ray33ee/DCT/schematics/debug_board/specs.md

# Debug board

## Features

- Lots of Gnd pins, as pairs scattered around the board for eazy access
- Breakout of entire dev board pins
- Lots of colored LEDs
	- Power LED
	- Hard Fault LED
	- Awaiting uart LED
	- Plus extras that can be connected via wires
- Label every pin
	- STM label
	- Dev board label
	- DCT label
- Reset button via RST (CN7_14)?
- Extra button

71.12
81.28
