ray33ee/DCT/controller/commands.md

# Commands

- Shut down: Turn voltage to 0. Set all pins to NC. Stop execution.
- Set current cutoff: Set the current threshold
- Ramp voltage: Ramp up voltage to desired level, noting the current drawn to detect shorts
- Load test: Take test source code, compile to byte code and send to device
- Start: Start and run a test until completion
- Step: Step over instructions one at a time
- Continue: If stepping, this will run the remainder of the code until completion
- Peek: Get the op and call stack pointers, instruction pointer, next instruction and top of op stack
