ray33ee/DCT/vault/Bytecode file format.md

- Bytecode is stored in a file
- This file contains a header with relevant information such as
	- Test voltage
	- Current limit
	- Pin count
	- Pin layout
	- Seed source (random or provided)
