ray33ee/DCT/vault/VM.md

User code is executed via a 64-bit 64 register VM. Instructions are:

Architecture:

VM uses 64 registers each with 64 bits (labelled r0-r64). Six (r0-r5) are used by the VM for special uses. 20 (r6-r25) are used to pass arguments to functions and to return values from functions. The remaining values (r26-r63) are used as local variables, and these are all you get as this VM does not support stack local variables. 

State:

Machine state is defined as 64 64-bit registers and a stack

- Math (0-19)
	- ADD (0)
	- SUB (1)
	- MUL (2)
	- RNG (3)
- Bitwise Logic (20-39)
	- OR (20)
	- XOR
	- AND
	- INV - One's complement
	- NEG - Two's Complement
	- SHL - Shift left
	- SHR - Shift right
	- BOOL
	- NOT 
- Control flow (40-59)
	- JMP (40)
	- ALLOC (41)
	- CALL (42)
	- RET (43)
	- EQ (44)
	- NE (45)
	- GT (46)
	- LT (47)
	- GE (48)
	- LE (49)
	- JT (50)
	- JF (51)
- Data transfer (60-79)
	- PUSHI
	- POPC
	- PUSHL
	- POPL
	- DROP
- GPIO setup (80-99)
	- SETUP - Setup pin 
	- READ - Read pin
	- WRITE - Write pin
- Timing (100-119)
	- DLA - Milliseconds delay
	- DLB - Microseconds delay
- USI (SPI, UART, I2C, 1-WIRE) (120-139)
- Misc (200-250)
	- HALT
	- SPEEK - Serial send peek
	- SPOP - Serial send pop

Bytecode:

Opcodes are 6 bit (upper 2 bits reserved for extended jumps), register indices are 1 byte, immediates are 4 byte, pin indices are 1 byte, pin setup codes are 1 byte, jump addresses are 34-bit (32 bit plus 2 bits borrowed from opcodes, allowing jumps in files spanning 16GB)
