ray33ee/DCT/schematics/micro/micro.kicad_pcb

## KiCad design schematics/micro/micro.kicad_pcb (2025-07-21)

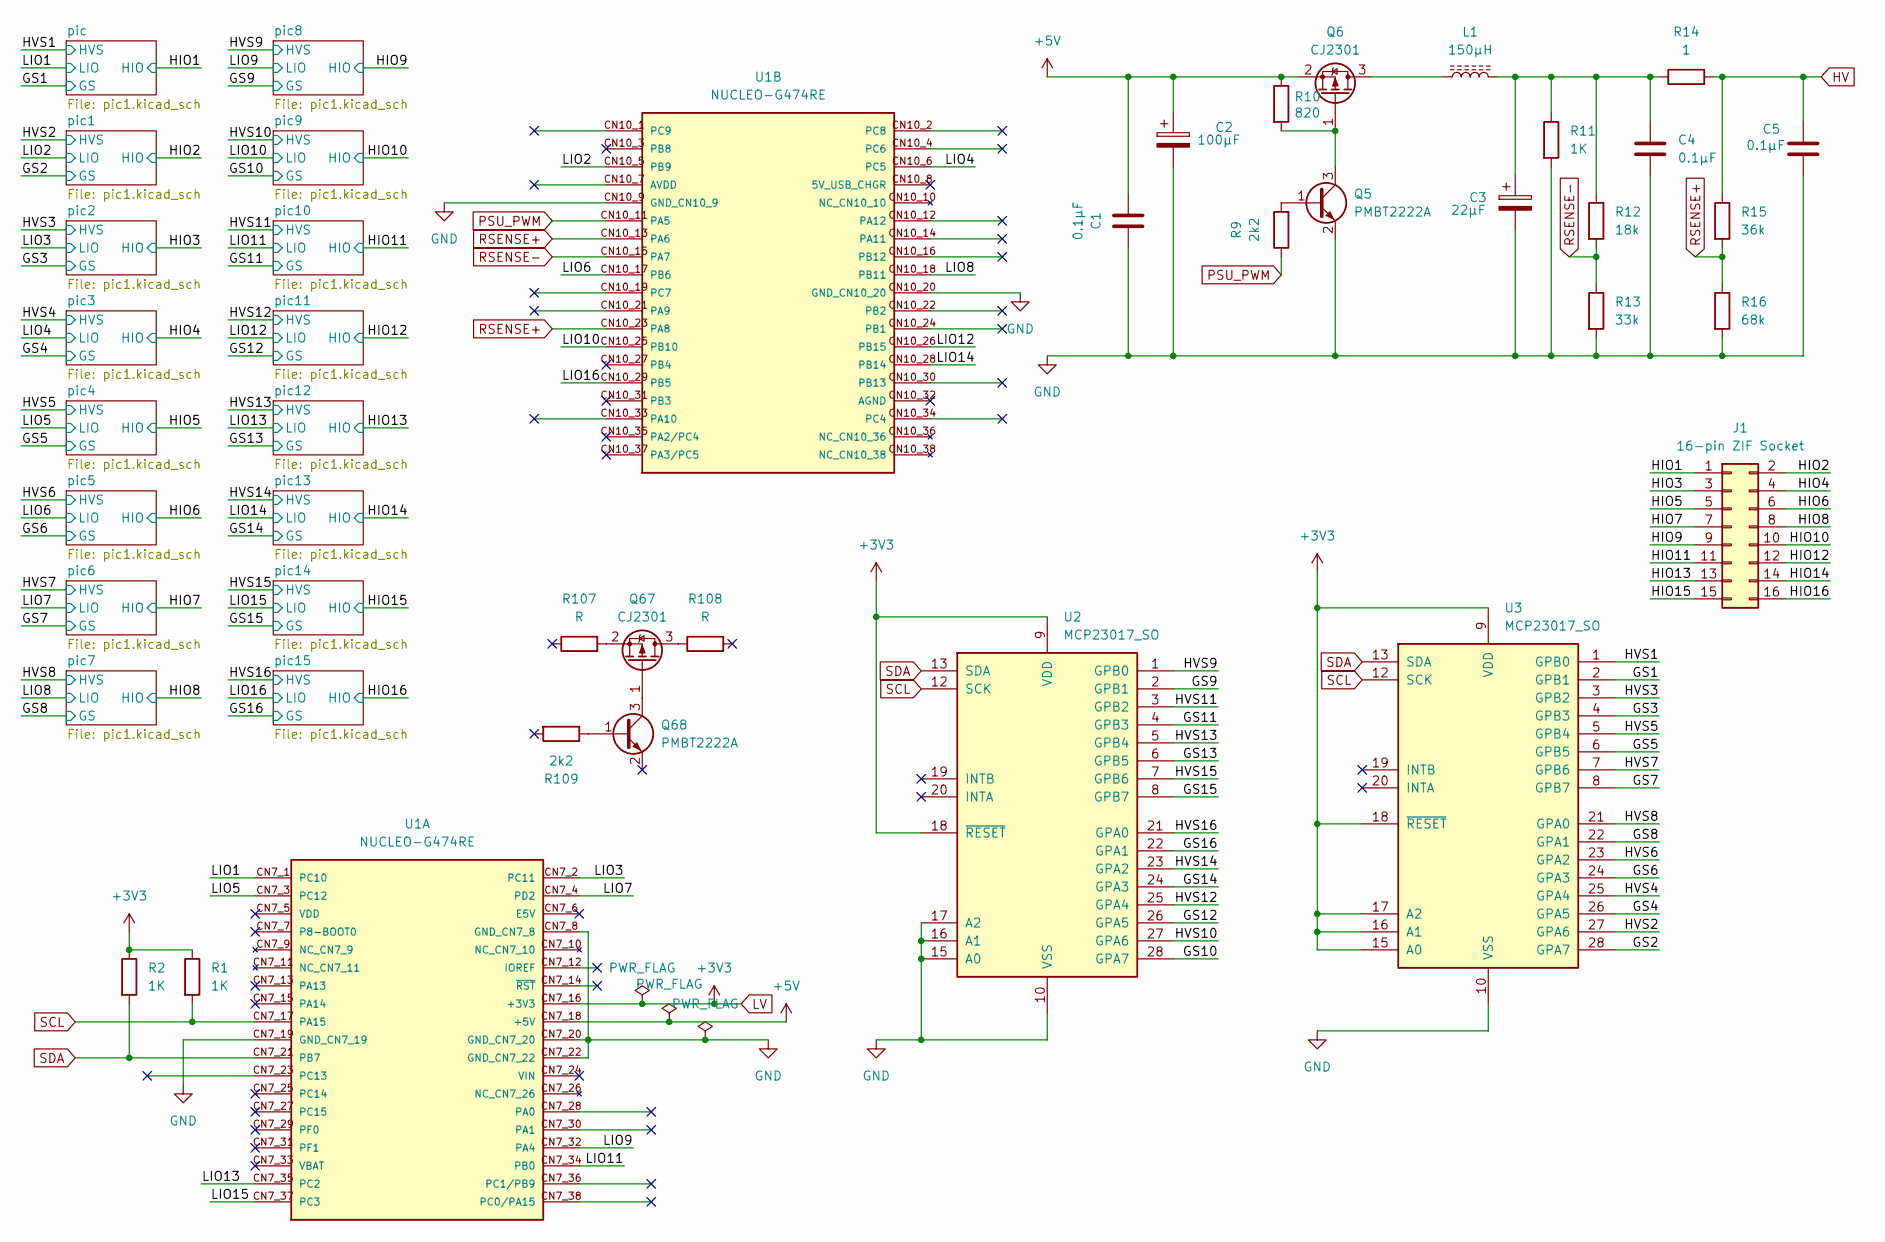
[picture p1: schematic micro.kicad_sch]

Parts:
C1, C4, C5: 0.1µF; C_1206_3216Metric_Pad1.33x1.80mm_HandSolder
C2: 100µF; CP_Elec_6.3x7.7
C3: 22µF; CP_Elec_6.3x5.4
J1: 16-pin ZIF Socket; ZIF-16
L1: 150µH; L_Axial_L11.0mm_D4.5mm_P15.24mm_Horizontal_Fastron_MECC
Q5, Q68: PMBT2222A; SOT-23
Q6, Q67: CJ2301; SOT-23
R1, R2, R11: 1K; R_1206_3216Metric_Pad1.30x1.75mm_HandSolder
R9, R109: 2k2; R_1206_3216Metric_Pad1.30x1.75mm_HandSolder
R10: 820; R_1206_3216Metric_Pad1.30x1.75mm_HandSolder
R12: 18k; R_1206_3216Metric_Pad1.30x1.75mm_HandSolder
R13: 33k; R_1206_3216Metric_Pad1.30x1.75mm_HandSolder
R14: 1; R_1206_3216Metric_Pad1.30x1.75mm_HandSolder
R15: 36k; R_1206_3216Metric_Pad1.30x1.75mm_HandSolder
R16: 68k; R_1206_3216Metric_Pad1.30x1.75mm_HandSolder
R107, R108: R; R_1206_3216Metric_Pad1.30x1.75mm_HandSolder
U1: NUCLEO-G474RE; G474; PARTREV 17; DigiKey_Part_Number 497-19491-ND
U2, U3: MCP23017_SO; SOIC-28W_7.5x17.9mm_P1.27mm

Connections:
+5V: C1.2, C2.1, Q6.2 (S), R10.1, U1.CN7_18 (+5V)
/GS1: U3.2 (GPB1); also elsewhere on the board
/GS2: U3.28 (GPA7); also elsewhere on the board
/GS3: U3.4 (GPB3); also elsewhere on the board
/GS4: U3.26 (GPA5); also elsewhere on the board
/GS5: U3.6 (GPB5); also elsewhere on the board
/GS6: U3.24 (GPA3); also elsewhere on the board
/GS7: U3.8 (GPB7); also elsewhere on the board
/GS8: U3.22 (GPA1); also elsewhere on the board
/GS9: U2.2 (GPB1); also elsewhere on the board
/GS10: U2.28 (GPA7); also elsewhere on the board
/GS11: U2.4 (GPB3); also elsewhere on the board
/GS12: U2.26 (GPA5); also elsewhere on the board
/GS13: U2.6 (GPB5); also elsewhere on the board
/GS14: U2.24 (GPA3); also elsewhere on the board
/GS15: U2.8 (GPB7); also elsewhere on the board
/GS16: U2.22 (GPA1); also elsewhere on the board
/HIO1: J1.1; also elsewhere on the board
/HIO2: J1.2; also elsewhere on the board
/HIO3: J1.3; also elsewhere on the board
/HIO4: J1.4; also elsewhere on the board
/HIO5: J1.5; also elsewhere on the board
/HIO6: J1.6; also elsewhere on the board
/HIO7: J1.7; also elsewhere on the board
/HIO8: J1.8; also elsewhere on the board
/HIO9: J1.9; also elsewhere on the board
/HIO10: J1.10; also elsewhere on the board
/HIO11: J1.11; also elsewhere on the board
/HIO12: J1.12; also elsewhere on the board
/HIO13: J1.13; also elsewhere on the board
/HIO14: J1.14; also elsewhere on the board
/HIO15: J1.15; also elsewhere on the board
/HIO16: J1.16; also elsewhere on the board
/HVS1: U3.1 (GPB0); also elsewhere on the board
/HVS2: U3.27 (GPA6); also elsewhere on the board
/HVS3: U3.3 (GPB2); also elsewhere on the board
/HVS4: U3.25 (GPA4); also elsewhere on the board
/HVS5: U3.5 (GPB4); also elsewhere on the board
/HVS6: U3.23 (GPA2); also elsewhere on the board
/HVS7: U3.7 (GPB6); also elsewhere on the board
/HVS8: U3.21 (GPA0); also elsewhere on the board
/HVS9: U2.1 (GPB0); also elsewhere on the board
/HVS10: U2.27 (GPA6); also elsewhere on the board
/HVS11: U2.3 (GPB2); also elsewhere on the board
/HVS12: U2.25 (GPA4); also elsewhere on the board
/HVS13: U2.5 (GPB4); also elsewhere on the board
/HVS14: U2.23 (GPA2); also elsewhere on the board
/HVS15: U2.7 (GPB6); also elsewhere on the board
/HVS16: U2.21 (GPA0); also elsewhere on the board
/LIO1: U1.CN7_1 (PC10); also elsewhere on the board
/LIO2: U1.CN10_5 (PB9); also elsewhere on the board
/LIO3: U1.CN7_2 (PC11); also elsewhere on the board
/LIO4: U1.CN10_6 (PC5); also elsewhere on the board
/LIO5: U1.CN7_3 (PC12); also elsewhere on the board
/LIO6: U1.CN10_17 (PB6); also elsewhere on the board
/LIO7: U1.CN7_4 (PD2); also elsewhere on the board
/LIO8: U1.CN10_18 (PB11); also elsewhere on the board
/LIO9: U1.CN7_32 (PA4); also elsewhere on the board
/LIO10: U1.CN10_25 (PB10); also elsewhere on the board
/LIO11: U1.CN7_34 (PB0); also elsewhere on the board
/LIO12: U1.CN10_26 (PB15); also elsewhere on the board
/LIO13: U1.CN7_35 (PC2); also elsewhere on the board
/LIO14: U1.CN10_28 (PB14); also elsewhere on the board
/LIO15: U1.CN7_37 (PC3); also elsewhere on the board
/LIO16: U1.CN10_29 (PB5); also elsewhere on the board
GND: C1.1, C2.2, C3.2, C4.2, C5.2, Q5.2 (E), R11.2, R13.2, R16.2, U1.CN7_8 (GND_CN7_8), U1.CN7_19 (GND_CN7_19), U1.CN7_20 (GND_CN7_20), U1.CN7_22 (GND_CN7_22), U1.CN10_9 (GND_CN10_9), U1.CN10_20 (GND_CN10_20), U2.10 (VSS), U2.15 (A0), U2.16 (A1), U2.17 (A2), U3.10 (VSS); also elsewhere on the board
HV: C5.1, R14.2, R15.1; also elsewhere on the board
LV: R1.1, R2.1, U1.CN7_16 (+3V3), U2.9 (VDD), U2.18 (~RESET), U3.9 (VDD), U3.15 (A0), U3.16 (A1), U3.17 (A2), U3.18 (~RESET); also elsewhere on the board
unnamed: C3.1, C4.1, L1.2, R11.1, R12.1, R14.1
unnamed: Q5.1 (B), R9.2
unnamed: Q5.3 (C), Q6.1 (G), R10.2
unnamed: L1.1, Q6.3 (D)
unnamed: Q67.3 (D), R108.1
unnamed: Q67.1 (G), Q68.3 (C)
unnamed: Q67.2 (S), R107.2
unnamed: Q68.1 (B), R109.1
PSU_PWM: R9.1, U1.CN10_11 (PA5)
RSENSE+: R15.2, R16.1, U1.CN10_13 (PA6), U1.CN10_23 (PA8)
RSENSE-: R12.2, R13.1, U1.CN10_15 (PA7)
SCL: R1.2, U1.CN7_17 (PA15), U2.12 (SCK), U3.12 (SCK)
SDA: R2.2, U1.CN7_21 (PB7), U2.13 (SDA), U3.13 (SDA)

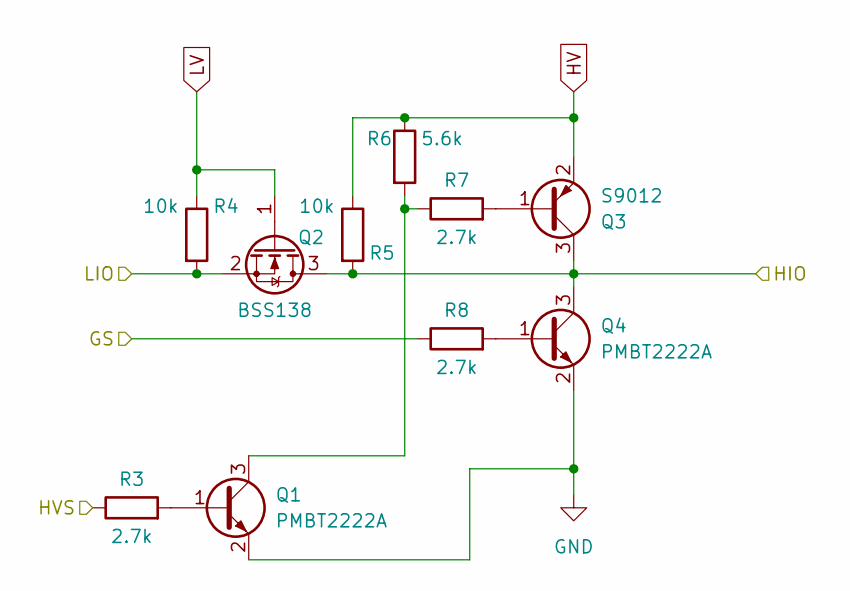
[picture p2: schematic pic1.kicad_sch]

Parts:
Q1, Q4: PMBT2222A; SOT-23_Handsoldering
Q2: BSS138; SOT-23_Handsoldering
Q3: S9012; SOT-23_Handsoldering
R3, R7, R8: 2.7k; R_1206_3216Metric_Pad1.30x1.75mm_HandSolder
R4, R5: 10k; R_1206_3216Metric_Pad1.30x1.75mm_HandSolder
R6: 5.6k; R_1206_3216Metric_Pad1.30x1.75mm_HandSolder

Connections:
/GS1: R8.1; also elsewhere on the board
/HIO1: Q2.3 (D), Q3.3 (C), Q4.3 (C), R5.2; also elsewhere on the board
/HVS1: R3.1; also elsewhere on the board
/LIO1: Q2.2 (S), R4.2; also elsewhere on the board
GND: Q1.2 (E), Q4.2 (E); also elsewhere on the board
HV: Q3.2 (E), R5.1, R6.1; also elsewhere on the board
LV: Q2.1 (G), R4.1; also elsewhere on the board
unnamed: Q1.1 (B), R3.2
unnamed: Q1.3 (C), R6.2, R7.1
unnamed: Q3.1 (B), R7.2
unnamed: Q4.1 (B), R8.2

Parts of its further copies:
Q7, Q10, Q11, Q14, Q15, Q18, Q19, Q22, Q23, Q26, Q27, Q30, Q31, Q34, Q35, Q38, Q39, Q42, Q43, Q46, Q47, Q50, Q51, Q54, Q55, Q58, Q59, Q62, Q63, Q66: PMBT2222A; SOT-23_Handsoldering
Q8, Q12, Q16, Q20, Q24, Q28, Q32, Q36, Q40, Q44, Q48, Q52, Q56, Q60, Q64: BSS138; SOT-23_Handsoldering
Q9, Q13, Q17, Q21, Q25, Q29, Q33, Q37, Q41, Q45, Q49, Q53, Q57, Q61, Q65: S9012; SOT-23_Handsoldering
R17, R21, R22, R23, R27, R28, R29, R33, R34, R35, R39, R40, R41, R45, R46, R47, R51, R52, R53, R57, R58, R59, R63, R64, R65, R69, R70, R71, R75, R76, R77, R81, R82, R83, R87, R88, R89, R93, R94, R95, R99, R100, R101, R105, R106: 2.7k; R_1206_3216Metric_Pad1.30x1.75mm_HandSolder
R18, R19, R24, R25, R30, R31, R36, R37, R42, R43, R48, R49, R54, R55, R60, R61, R66, R67, R72, R73, R78, R79, R84, R85, R90, R91, R96, R97, R102, R103: 10k; R_1206_3216Metric_Pad1.30x1.75mm_HandSolder
R20, R26, R32, R38, R44, R50, R56, R62, R68, R74, R80, R86, R92, R98, R104: 5.6k; R_1206_3216Metric_Pad1.30x1.75mm_HandSolder

Connections of its further copies:
/GS2: R22.1; also elsewhere on the board
/GS3: R28.1; also elsewhere on the board
/GS4: R34.1; also elsewhere on the board
/GS5: R40.1; also elsewhere on the board
/GS6: R46.1; also elsewhere on the board
/GS7: R52.1; also elsewhere on the board
/GS8: R58.1; also elsewhere on the board
/GS9: R64.1; also elsewhere on the board
/GS10: R70.1; also elsewhere on the board
/GS11: R76.1; also elsewhere on the board
/GS12: R82.1; also elsewhere on the board
/GS13: R88.1; also elsewhere on the board
/GS14: R94.1; also elsewhere on the board
/GS15: R100.1; also elsewhere on the board
/GS16: R106.1; also elsewhere on the board
/HIO2: Q8.3 (D), Q9.3 (C), Q10.3 (C), R19.2; also elsewhere on the board
/HIO3: Q12.3 (D), Q13.3 (C), Q14.3 (C), R25.2; also elsewhere on the board
/HIO4: Q16.3 (D), Q17.3 (C), Q18.3 (C), R31.2; also elsewhere on the board
/HIO5: Q20.3 (D), Q21.3 (C), Q22.3 (C), R37.2; also elsewhere on the board
/HIO6: Q24.3 (D), Q25.3 (C), Q26.3 (C), R43.2; also elsewhere on the board
/HIO7: Q28.3 (D), Q29.3 (C), Q30.3 (C), R49.2; also elsewhere on the board
/HIO8: Q32.3 (D), Q33.3 (C), Q34.3 (C), R55.2; also elsewhere on the board
/HIO9: Q36.3 (D), Q37.3 (C), Q38.3 (C), R61.2; also elsewhere on the board
/HIO10: Q40.3 (D), Q41.3 (C), Q42.3 (C), R67.2; also elsewhere on the board
/HIO11: Q44.3 (D), Q45.3 (C), Q46.3 (C), R73.2; also elsewhere on the board
/HIO12: Q48.3 (D), Q49.3 (C), Q50.3 (C), R79.2; also elsewhere on the board
/HIO13: Q52.3 (D), Q53.3 (C), Q54.3 (C), R85.2; also elsewhere on the board
/HIO14: Q56.3 (D), Q57.3 (C), Q58.3 (C), R91.2; also elsewhere on the board
/HIO15: Q60.3 (D), Q61.3 (C), Q62.3 (C), R97.2; also elsewhere on the board
/HIO16: Q64.3 (D), Q65.3 (C), Q66.3 (C), R103.2; also elsewhere on the board
/HVS2: R17.1; also elsewhere on the board
/HVS3: R23.1; also elsewhere on the board
/HVS4: R29.1; also elsewhere on the board
/HVS5: R35.1; also elsewhere on the board
/HVS6: R41.1; also elsewhere on the board
/HVS7: R47.1; also elsewhere on the board
/HVS8: R53.1; also elsewhere on the board
/HVS9: R59.1; also elsewhere on the board
/HVS10: R65.1; also elsewhere on the board
/HVS11: R71.1; also elsewhere on the board
/HVS12: R77.1; also elsewhere on the board
/HVS13: R83.1; also elsewhere on the board
/HVS14: R89.1; also elsewhere on the board
/HVS15: R95.1; also elsewhere on the board
/HVS16: R101.1; also elsewhere on the board
/LIO2: Q8.2 (S), R18.2; also elsewhere on the board
/LIO3: Q12.2 (S), R24.2; also elsewhere on the board
/LIO4: Q16.2 (S), R30.2; also elsewhere on the board
/LIO5: Q20.2 (S), R36.2; also elsewhere on the board
/LIO6: Q24.2 (S), R42.2; also elsewhere on the board
/LIO7: Q28.2 (S), R48.2; also elsewhere on the board
/LIO8: Q32.2 (S), R54.2; also elsewhere on the board
/LIO9: Q36.2 (S), R60.2; also elsewhere on the board
/LIO10: Q40.2 (S), R66.2; also elsewhere on the board
/LIO11: Q44.2 (S), R72.2; also elsewhere on the board
/LIO12: Q48.2 (S), R78.2; also elsewhere on the board
/LIO13: Q52.2 (S), R84.2; also elsewhere on the board
/LIO14: Q56.2 (S), R90.2; also elsewhere on the board
/LIO15: Q60.2 (S), R96.2; also elsewhere on the board
/LIO16: Q64.2 (S), R102.2; also elsewhere on the board
GND: Q7.2 (E), Q10.2 (E), Q11.2 (E), Q14.2 (E), Q15.2 (E), Q18.2 (E), Q19.2 (E), Q22.2 (E), Q23.2 (E), Q26.2 (E), Q27.2 (E), Q30.2 (E), Q31.2 (E), Q34.2 (E), Q35.2 (E), Q38.2 (E), Q39.2 (E), Q42.2 (E), Q43.2 (E), Q46.2 (E), Q47.2 (E), Q50.2 (E), Q51.2 (E), Q54.2 (E), Q55.2 (E), Q58.2 (E), Q59.2 (E), Q62.2 (E), Q63.2 (E), Q66.2 (E); also elsewhere on the board
HV: Q9.2 (E), Q13.2 (E), Q17.2 (E), Q21.2 (E), Q25.2 (E), Q29.2 (E), Q33.2 (E), Q37.2 (E), Q41.2 (E), Q45.2 (E), Q49.2 (E), Q53.2 (E), Q57.2 (E), Q61.2 (E), Q65.2 (E), R19.1, R20.1, R25.1, R26.1, R31.1, R32.1, R37.1, R38.1, R43.1, R44.1, R49.1, R50.1, R55.1, R56.1, R61.1, R62.1, R67.1, R68.1, R73.1, R74.1, R79.1, R80.1, R85.1, R86.1, R91.1, R92.1, R97.1, R98.1, R103.1, R104.1; also elsewhere on the board
LV: Q8.1 (G), Q12.1 (G), Q16.1 (G), Q20.1 (G), Q24.1 (G), Q28.1 (G), Q32.1 (G), Q36.1 (G), Q40.1 (G), Q44.1 (G), Q48.1 (G), Q52.1 (G), Q56.1 (G), Q60.1 (G), Q64.1 (G), R18.1, R24.1, R30.1, R36.1, R42.1, R48.1, R54.1, R60.1, R66.1, R72.1, R78.1, R84.1, R90.1, R96.1, R102.1; also elsewhere on the board
unnamed: Q7.1 (B), R17.2
unnamed: Q7.3 (C), R20.2, R21.1
unnamed: Q9.1 (B), R21.2
unnamed: Q10.1 (B), R22.2
unnamed: Q11.1 (B), R23.2
unnamed: Q11.3 (C), R26.2, R27.1
unnamed: Q13.1 (B), R27.2
unnamed: Q14.1 (B), R28.2
unnamed: Q15.1 (B), R29.2
unnamed: Q15.3 (C), R32.2, R33.1
unnamed: Q17.1 (B), R33.2
unnamed: Q18.1 (B), R34.2
unnamed: Q19.1 (B), R35.2
unnamed: Q19.3 (C), R38.2, R39.1
unnamed: Q21.1 (B), R39.2
unnamed: Q22.1 (B), R40.2
unnamed: Q23.1 (B), R41.2
unnamed: Q23.3 (C), R44.2, R45.1
unnamed: Q25.1 (B), R45.2
unnamed: Q26.1 (B), R46.2
unnamed: Q27.1 (B), R47.2
unnamed: Q27.3 (C), R50.2, R51.1
unnamed: Q29.1 (B), R51.2
unnamed: Q30.1 (B), R52.2
unnamed: Q31.1 (B), R53.2
unnamed: Q31.3 (C), R56.2, R57.1
unnamed: Q33.1 (B), R57.2
unnamed: Q34.1 (B), R58.2
unnamed: Q35.1 (B), R59.2
unnamed: Q35.3 (C), R62.2, R63.1
unnamed: Q37.1 (B), R63.2
unnamed: Q38.1 (B), R64.2
unnamed: Q39.1 (B), R65.2
unnamed: Q39.3 (C), R68.2, R69.1
unnamed: Q41.1 (B), R69.2
unnamed: Q42.1 (B), R70.2
unnamed: Q43.1 (B), R71.2
unnamed: Q43.3 (C), R74.2, R75.1
unnamed: Q45.1 (B), R75.2
unnamed: Q46.1 (B), R76.2
unnamed: Q47.1 (B), R77.2
unnamed: Q47.3 (C), R80.2, R81.1
unnamed: Q49.1 (B), R81.2
unnamed: Q50.1 (B), R82.2
unnamed: Q51.1 (B), R83.2
unnamed: Q51.3 (C), R86.2, R87.1
unnamed: Q53.1 (B), R87.2
unnamed: Q54.1 (B), R88.2
unnamed: Q55.1 (B), R89.2
unnamed: Q55.3 (C), R92.2, R93.1
unnamed: Q57.1 (B), R93.2
unnamed: Q58.1 (B), R94.2
unnamed: Q59.1 (B), R95.2
unnamed: Q59.3 (C), R98.2, R99.1
unnamed: Q61.1 (B), R99.2
unnamed: Q62.1 (B), R100.2
unnamed: Q63.1 (B), R101.2
unnamed: Q63.3 (C), R104.2, R105.1
unnamed: Q65.1 (B), R105.2
unnamed: Q66.1 (B), R106.2

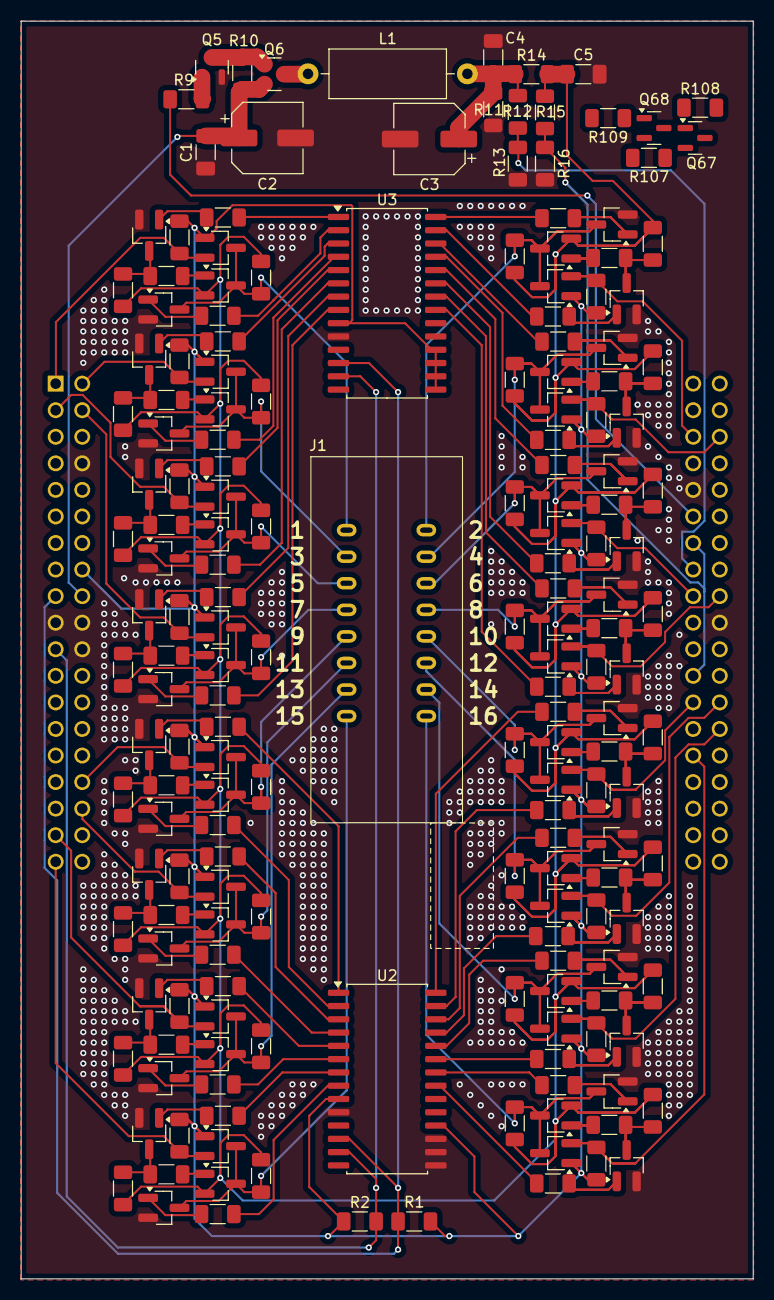
[picture p3: board micro.kicad_pcb from above]

Board: 2 copper layers, 70.0 x 120.3 mm, 187 parts (0 on the bottom side), 145 nets.
