ray33ee/DCT/schematics/debug_board/debug/debug.kicad_pcb

## KiCad design schematics/debug_board/debug/debug.kicad_pcb (2025-07-21)

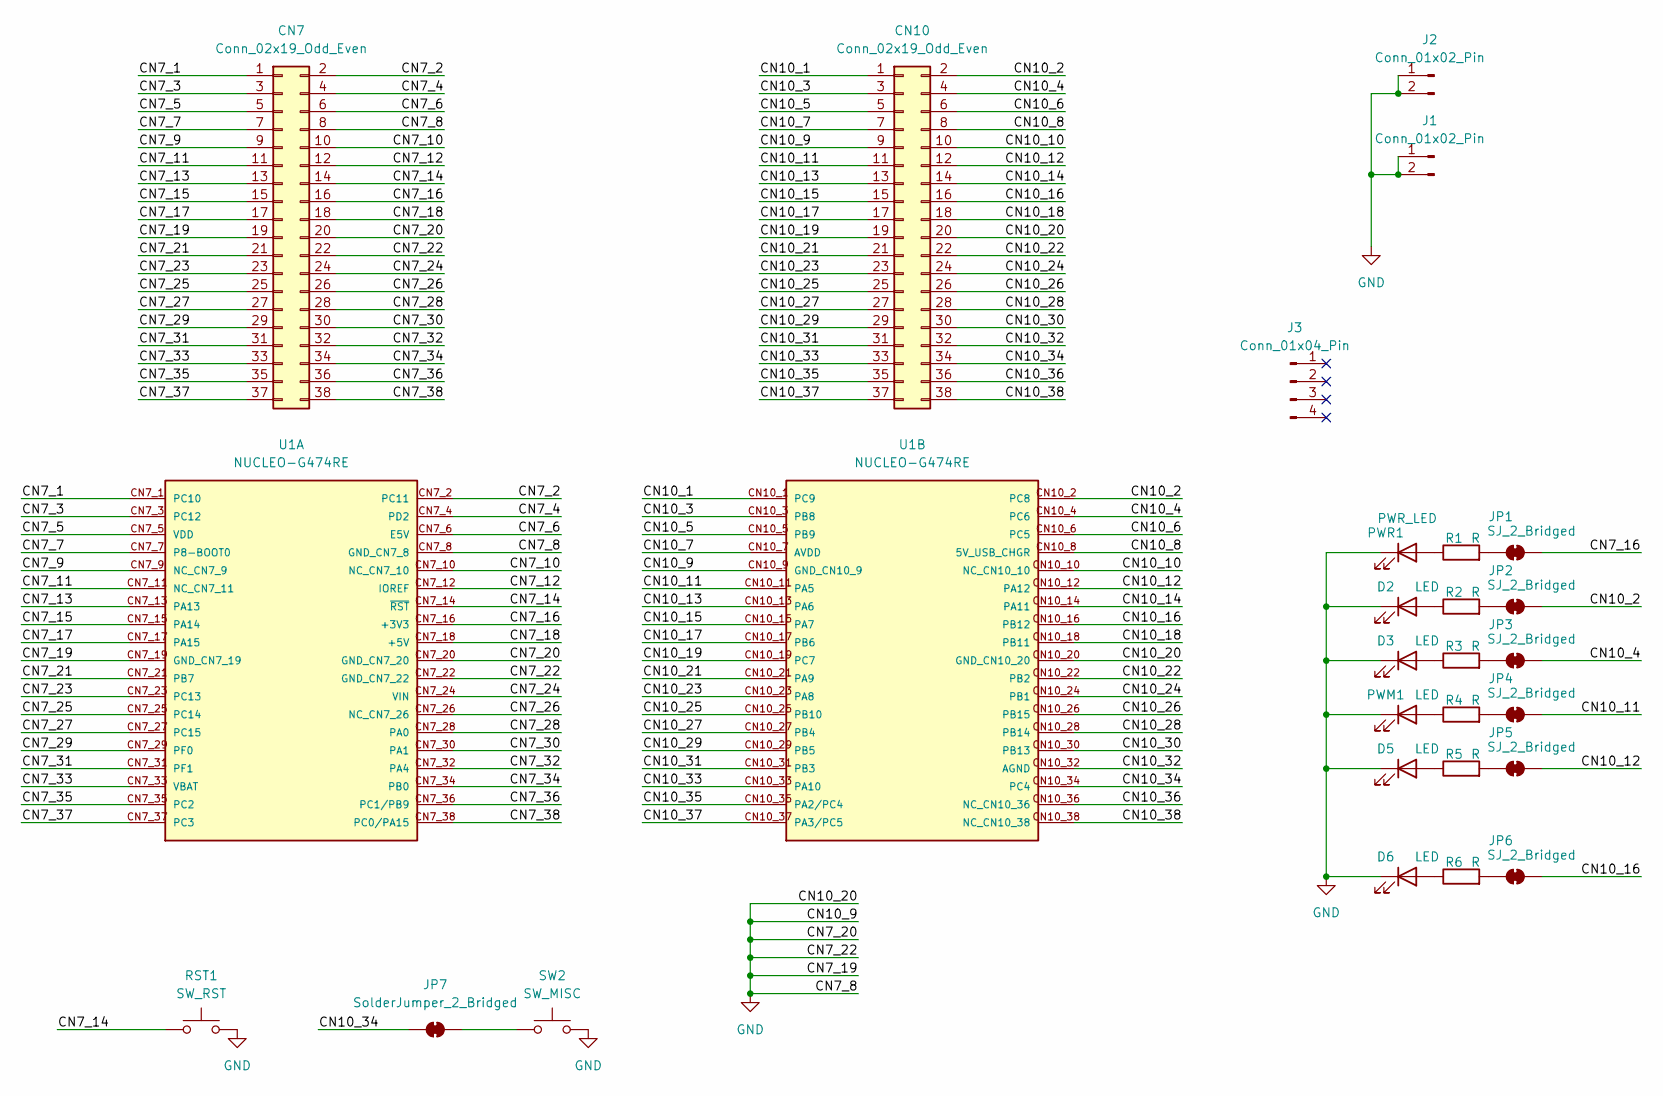
[picture p4: schematic debug.kicad_sch]

Parts:
CN7, CN10: Conn_02x19_Odd_Even; PinHeader_2x19_P2.54mm_Vertical
D2, D3, D5, D6: LED; LED_1206_3216Metric_Pad1.42x1.75mm_HandSolder
J1, J2: Conn_01x02_Pin; PinHeader_2x01_P2.54mm_Vertical
J3: Conn_01x04_Pin; PinHeader_1x04_P2.54mm_Vertical
JP1, JP2, JP3, JP4, JP5, JP6: SJ_2_Bridged; SolderJumper-2_P1.3mm_Bridged_RoundedPad1.0x1.5mm
JP7: SolderJumper_2_Bridged; SolderJumper-2_P1.3mm_Bridged_RoundedPad1.0x1.5mm
PWM1: LED; LED_1206_3216Metric_Pad1.42x1.75mm_HandSolder
PWR1: PWR_LED; LED_1206_3216Metric_Pad1.42x1.75mm_HandSolder
R1, R2, R3, R4, R5, R6: R; R_1206_3216Metric_Pad1.30x1.75mm_HandSolder
RST1: SW_RST; SW_SPST_FSMSM
SW2: SW_MISC; SW_SPST_FSMSM
U1: NUCLEO-G474RE; G474; PARTREV 17; DigiKey_Part_Number 497-19491-ND

Connections:
/CN7_1: CN7.1, U1.CN7_1 (PC10)
/CN7_2: CN7.2, U1.CN7_2 (PC11)
/CN7_3: CN7.3, U1.CN7_3 (PC12)
/CN7_4: CN7.4, U1.CN7_4 (PD2)
/CN7_5: CN7.5, U1.CN7_5 (VDD)
/CN7_6: CN7.6, U1.CN7_6 (E5V)
/CN7_7: CN7.7, U1.CN7_7 (P8-BOOT0)
/CN7_9: CN7.9, U1.CN7_9 (NC_CN7_9)
/CN7_10: CN7.10, U1.CN7_10 (NC_CN7_10)
/CN7_11: CN7.11, U1.CN7_11 (NC_CN7_11)
/CN7_12: CN7.12, U1.CN7_12 (IOREF)
/CN7_13: CN7.13, U1.CN7_13 (PA13)
/CN7_14: CN7.14, RST1.1, U1.CN7_14 (~RST)
/CN7_15: CN7.15, U1.CN7_15 (PA14)
/CN7_16: CN7.16, JP1.2 (B), U1.CN7_16 (+3V3)
/CN7_17: CN7.17, U1.CN7_17 (PA15)
/CN7_18: CN7.18, U1.CN7_18 (+5V)
/CN7_21: CN7.21, U1.CN7_21 (PB7)
/CN7_23: CN7.23, U1.CN7_23 (PC13)
/CN7_24: CN7.24, U1.CN7_24 (VIN)
/CN7_25: CN7.25, U1.CN7_25 (PC14)
/CN7_26: CN7.26, U1.CN7_26 (NC_CN7_26)
/CN7_27: CN7.27, U1.CN7_27 (PC15)
/CN7_28: CN7.28, U1.CN7_28 (PA0)
/CN7_29: CN7.29, U1.CN7_29 (PF0)
/CN7_30: CN7.30, U1.CN7_30 (PA1)
/CN7_31: CN7.31, U1.CN7_31 (PF1)
/CN7_32: CN7.32, U1.CN7_32 (PA4)
/CN7_33: CN7.33, U1.CN7_33 (VBAT)
/CN7_34: CN7.34, U1.CN7_34 (PB0)
/CN7_35: CN7.35, U1.CN7_35 (PC2)
/CN7_36: CN7.36, U1.CN7_36 (PC1/PB9)
/CN7_37: CN7.37, U1.CN7_37 (PC3)
/CN7_38: CN7.38, U1.CN7_38 (PC0/PA15)
/CN10_1: CN10.1, U1.CN10_1 (PC9)
/CN10_2: CN10.2, JP2.2 (B), U1.CN10_2 (PC8)
/CN10_3: CN10.3, U1.CN10_3 (PB8)
/CN10_4: CN10.4, JP3.2 (B), U1.CN10_4 (PC6)
/CN10_5: CN10.5, U1.CN10_5 (PB9)
/CN10_6: CN10.6, U1.CN10_6 (PC5)
/CN10_7: CN10.7, U1.CN10_7 (AVDD)
/CN10_8: CN10.8, U1.CN10_8 (5V_USB_CHGR)
/CN10_10: CN10.10, U1.CN10_10 (NC_CN10_10)
/CN10_11: CN10.11, JP4.2 (B), U1.CN10_11 (PA5)
/CN10_12: CN10.12, JP5.2 (B), U1.CN10_12 (PA12)
/CN10_13: CN10.13, U1.CN10_13 (PA6)
/CN10_14: CN10.14, U1.CN10_14 (PA11)
/CN10_15: CN10.15, U1.CN10_15 (PA7)
/CN10_16: CN10.16, JP6.2 (B), U1.CN10_16 (PB12)
/CN10_17: CN10.17, U1.CN10_17 (PB6)
/CN10_18: CN10.18, U1.CN10_18 (PB11)
/CN10_19: CN10.19, U1.CN10_19 (PC7)
/CN10_21: CN10.21, U1.CN10_21 (PA9)
/CN10_22: CN10.22, U1.CN10_22 (PB2)
/CN10_23: CN10.23, U1.CN10_23 (PA8)
/CN10_24: CN10.24, U1.CN10_24 (PB1)
/CN10_25: CN10.25, U1.CN10_25 (PB10)
/CN10_26: CN10.26, U1.CN10_26 (PB15)
/CN10_27: CN10.27, U1.CN10_27 (PB4)
/CN10_28: CN10.28, U1.CN10_28 (PB14)
/CN10_29: CN10.29, U1.CN10_29 (PB5)
/CN10_30: CN10.30, U1.CN10_30 (PB13)
/CN10_31: CN10.31, U1.CN10_31 (PB3)
/CN10_32: CN10.32, U1.CN10_32 (AGND)
/CN10_33: CN10.33, U1.CN10_33 (PA10)
/CN10_34: CN10.34, JP7.1 (A), U1.CN10_34 (PC4)
/CN10_35: CN10.35, U1.CN10_35 (PA2/PC4)
/CN10_36: CN10.36, U1.CN10_36 (NC_CN10_36)
/CN10_37: CN10.37, U1.CN10_37 (PA3/PC5)
/CN10_38: CN10.38, U1.CN10_38 (NC_CN10_38)
GND: CN7.8, CN7.19, CN7.20, CN7.22, CN10.9, CN10.20, D2.1 (K), D3.1 (K), D5.1 (K), D6.1 (K), J1.1, J1.2, J2.1, J2.2, PWM1.1 (K), PWR1.1 (K), RST1.2, SW2.2, U1.CN7_8 (GND_CN7_8), U1.CN7_19 (GND_CN7_19), U1.CN7_20 (GND_CN7_20), U1.CN7_22 (GND_CN7_22), U1.CN10_9 (GND_CN10_9), U1.CN10_20 (GND_CN10_20)
unnamed: D2.2 (A), R2.1
unnamed: D3.2 (A), R3.1
unnamed: D5.2 (A), R5.1
unnamed: D6.2 (A), R6.1
unnamed: JP1.1 (A), R1.2
unnamed: JP2.1 (A), R2.2
unnamed: JP3.1 (A), R3.2
unnamed: JP4.1 (A), R4.2
unnamed: JP5.1 (A), R5.2
unnamed: JP6.1 (A), R6.2
unnamed: JP7.2 (B), SW2.1
unnamed: PWM1.2 (A), R4.1
unnamed: PWR1.2 (A), R1.1

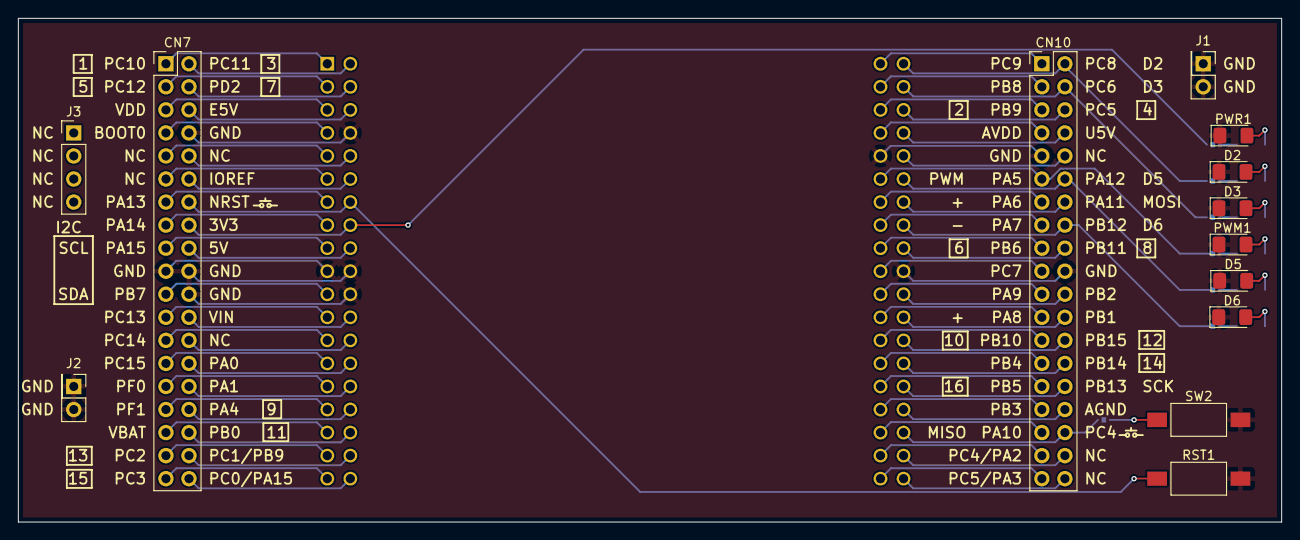
[picture p5: board debug.kicad_pcb from above]

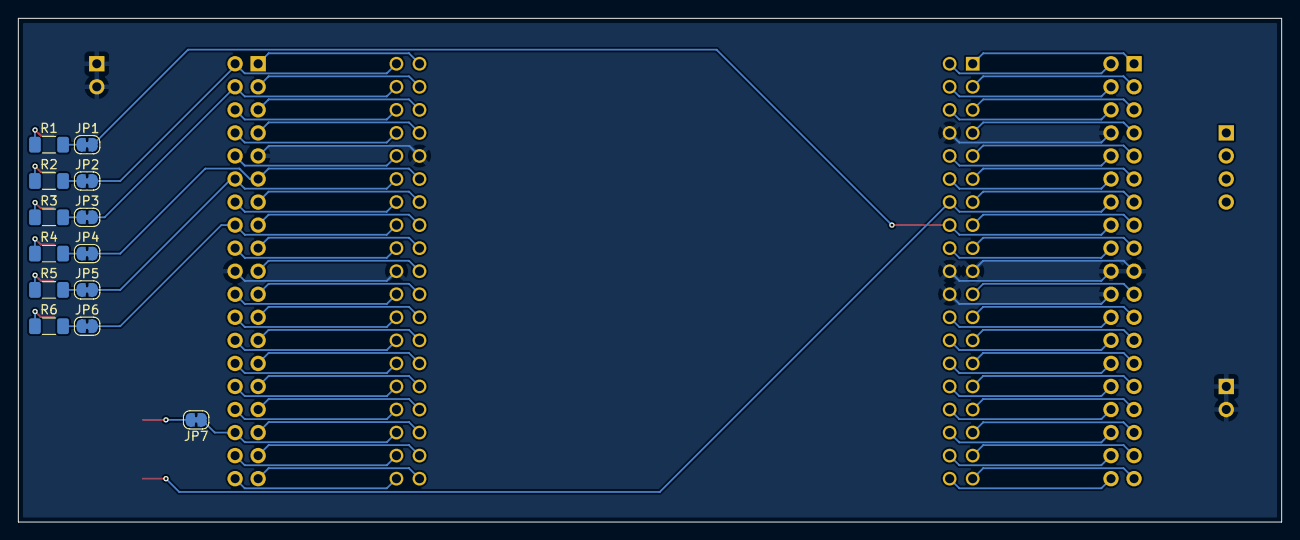
[picture p6: board debug.kicad_pcb from below]

Board: 2 copper layers, 139.2 x 55.5 mm, 27 parts (13 on the bottom side), 84 nets.
