ray33ee/DCT/schematics/PSU/PSU.kicad_pcb

## KiCad design schematics/PSU/PSU.kicad_pcb (2024-12-12)

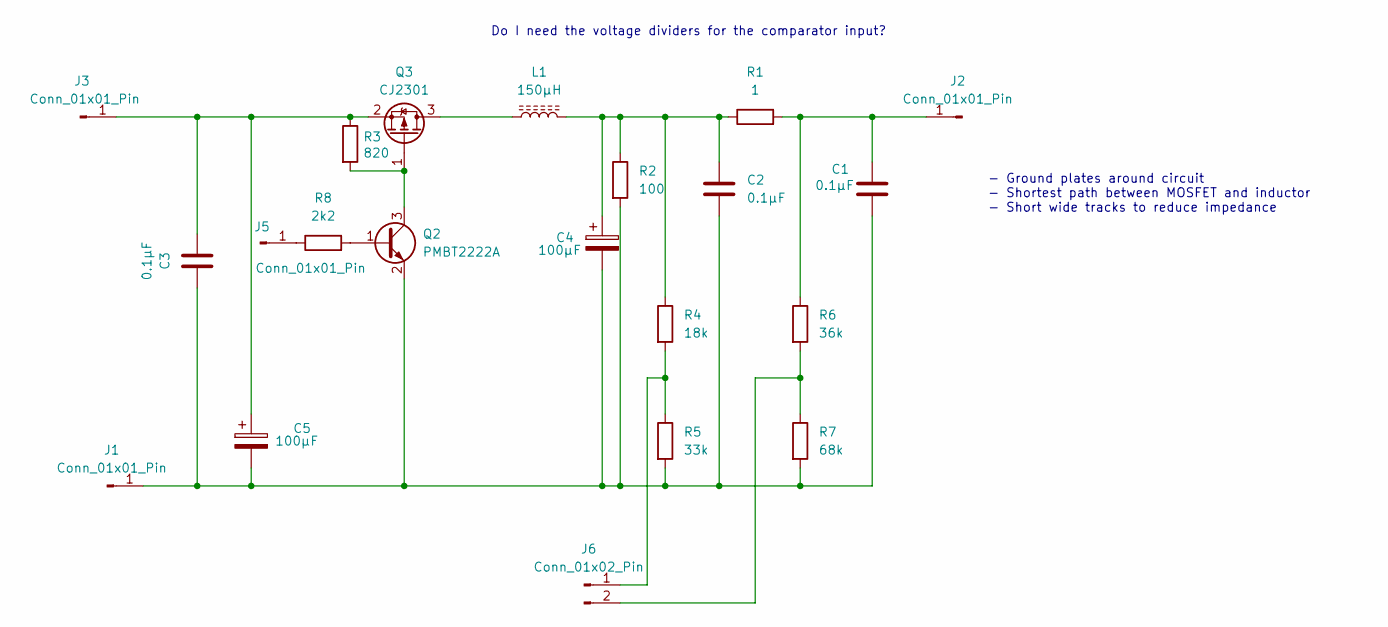
[picture p7: schematic PSU.kicad_sch]

Parts:
C1, C2, C3: 0.1µF; C_1206_3216Metric_Pad1.33x1.80mm_HandSolder
C4, C5: 100µF; CP_Radial_D10.0mm_P5.00mm
J1, J2, J3, J5: Conn_01x01_Pin; PinHeader_1x01_P2.54mm_Vertical
J6: Conn_01x02_Pin; PinHeader_1x02_P2.54mm_Vertical
L1: 150µH; L_Axial_L11.0mm_D4.5mm_P15.24mm_Horizontal_Fastron_MECC
Q2: PMBT2222A; SOT-23
Q3: CJ2301; SOT-23
R1: 1; R_1206_3216Metric_Pad1.30x1.75mm_HandSolder
R2: 100; R_2512_6332Metric_Pad1.40x3.35mm_HandSolder
R3: 820; R_1206_3216Metric_Pad1.30x1.75mm_HandSolder
R4: 18k; R_1206_3216Metric_Pad1.30x1.75mm_HandSolder
R5: 33k; R_1206_3216Metric_Pad1.30x1.75mm_HandSolder
R6: 36k; R_1206_3216Metric_Pad1.30x1.75mm_HandSolder
R7: 68k; R_1206_3216Metric_Pad1.30x1.75mm_HandSolder
R8: 2k2; R_1206_3216Metric_Pad1.30x1.75mm_HandSolder

Connections:
unnamed: C2.1, C4.1, L1.2, R1.1, R2.1, R4.1
unnamed: C1.2, C2.2, C3.1, C4.2, C5.2, J1.1, Q2.2 (E), R2.2, R5.2, R7.2
unnamed: C1.1, J2.1, R1.2, R6.1
unnamed: C3.2, C5.1, J3.1, Q3.2 (S), R3.1
unnamed: J5.1, R8.1
unnamed: J6.1, R4.2, R5.1
unnamed: J6.2, R6.2, R7.1
unnamed: Q2.1 (B), R8.2
unnamed: Q2.3 (C), Q3.1 (G), R3.2
unnamed: L1.1, Q3.3 (D)

Notes on the sheet:
- Ground plates around circuit - Shortest path between MOSFET and inductor - Short wide tracks to reduce impedance
Do I need the voltage dividers for the comparator input?

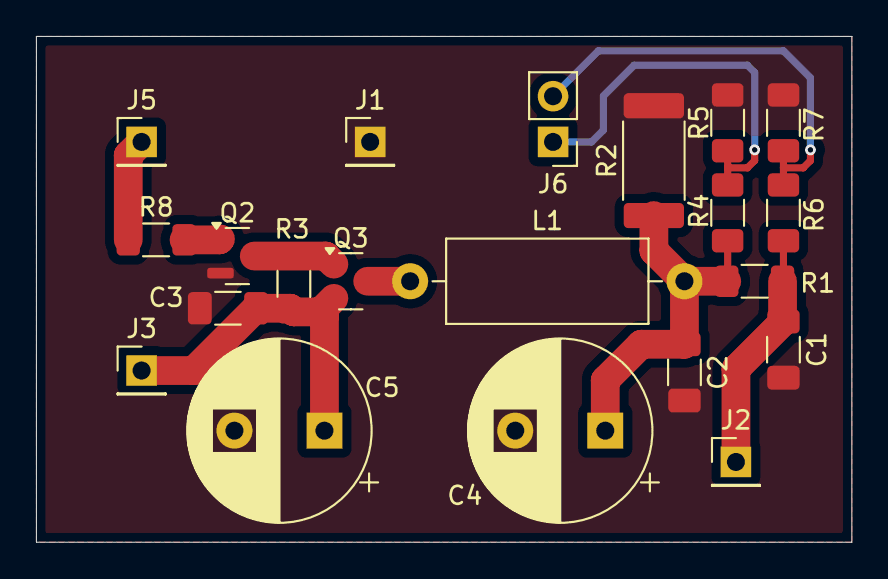
[picture p8: board PSU.kicad_pcb from above]

Board: 2 copper layers, 45.3 x 28.1 mm, 21 parts (0 on the bottom side), 10 nets.
