ray33ee/DCT/schematics/pin_interface_circuit/pin_interface_circuit.kicad_pcb

## KiCad design schematics/pin_interface_circuit/pin_interface_circuit.kicad_pcb (2024-11-22)

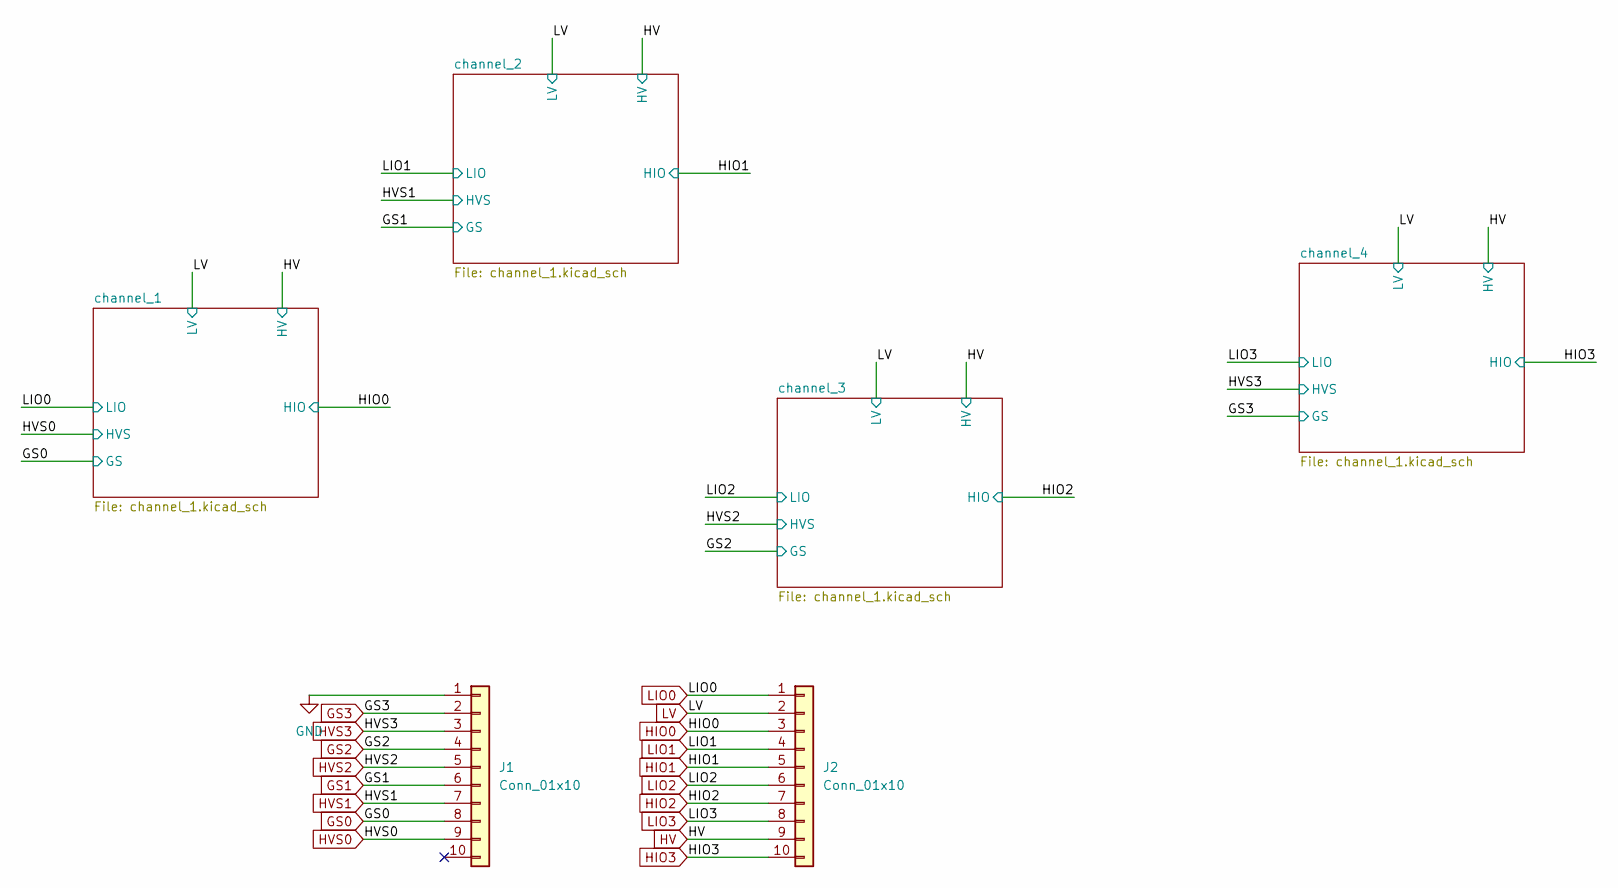
[picture p9: schematic pin_interface_circuit.kicad_sch]

Parts:
J1, J2: Conn_01x10; PinHeader_1x10_P2.54mm_Vertical

Connections:
GND: J1.1; also elsewhere on the board
GS0: J1.8; also elsewhere on the board
GS1: J1.6; also elsewhere on the board
GS2: J1.4; also elsewhere on the board
GS3: J1.2; also elsewhere on the board
HIO0: J2.3; also elsewhere on the board
HIO1: J2.5; also elsewhere on the board
HIO2: J2.7; also elsewhere on the board
HIO3: J2.10; also elsewhere on the board
HV: J2.9; also elsewhere on the board
HVS0: J1.9; also elsewhere on the board
HVS1: J1.7; also elsewhere on the board
HVS2: J1.5; also elsewhere on the board
HVS3: J1.3; also elsewhere on the board
LIO0: J2.1; also elsewhere on the board
LIO1: J2.4; also elsewhere on the board
LIO2: J2.6; also elsewhere on the board
LIO3: J2.8; also elsewhere on the board
LV: J2.2; also elsewhere on the board
