ray33ee/DCT/schematics/pin_interface_circuit/pin_interface_circuit.kicad_pcb

## KiCad design schematics/pin_interface_circuit/pin_interface_circuit.kicad_pcb (continued)

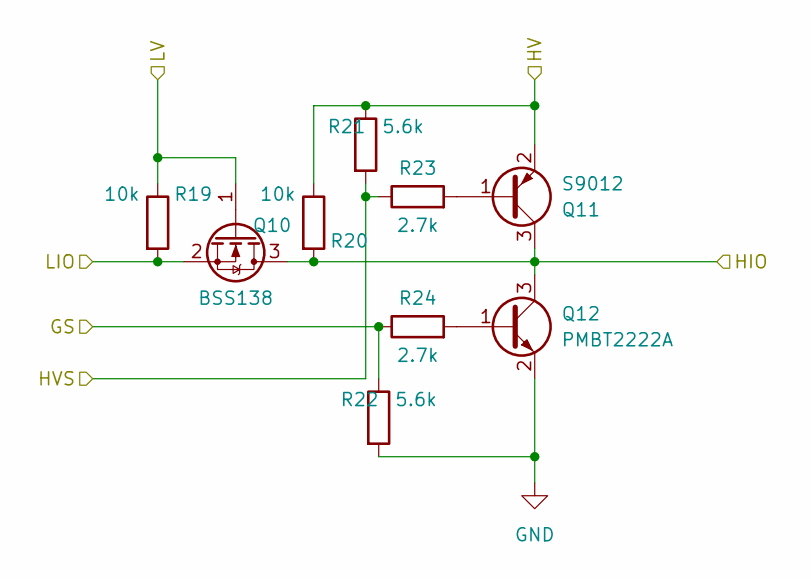
[picture p10: schematic channel_1.kicad_sch]

Parts:
Q10: BSS138; SOT-23_Handsoldering
Q11: S9012; SOT-23_Handsoldering
Q12: PMBT2222A; SOT-23_Handsoldering
R19, R20: 10k; R_1206_3216Metric_Pad1.30x1.75mm_HandSolder
R21, R22: 5.6k; R_1206_3216Metric_Pad1.30x1.75mm_HandSolder
R23, R24: 2.7k; R_1206_3216Metric_Pad1.30x1.75mm_HandSolder

Connections:
GND: Q12.2 (E), R22.2; also elsewhere on the board
GS3: R22.1, R24.1; also elsewhere on the board
HIO3: Q10.3 (D), Q11.3 (C), Q12.3 (C), R20.2; also elsewhere on the board
HV: Q11.2 (E), R20.1, R21.1; also elsewhere on the board
HVS3: R21.2, R23.1; also elsewhere on the board
LIO3: Q10.2 (S), R19.2; also elsewhere on the board
LV: Q10.1 (G), R19.1; also elsewhere on the board
unnamed: Q11.1 (B), R23.2
unnamed: Q12.1 (B), R24.2

Parts of its further copies:
Q1, Q4, Q7: BSS138; SOT-23_Handsoldering
Q2, Q5, Q8: S9012; SOT-23_Handsoldering
Q3, Q6, Q9: PMBT2222A; SOT-23_Handsoldering
R1, R2, R7, R8, R13, R14: 10k; R_1206_3216Metric_Pad1.30x1.75mm_HandSolder
R3, R4, R9, R10, R15, R16: 5.6k; R_1206_3216Metric_Pad1.30x1.75mm_HandSolder
R5, R6, R11, R12, R17, R18: 2.7k; R_1206_3216Metric_Pad1.30x1.75mm_HandSolder

Connections of its further copies:
GND: Q3.2 (E), Q6.2 (E), Q9.2 (E), R4.2, R10.2, R16.2; also elsewhere on the board
GS0: R4.1, R6.1; also elsewhere on the board
GS1: R10.1, R12.1; also elsewhere on the board
GS2: R16.1, R18.1; also elsewhere on the board
HIO0: Q1.3 (D), Q2.3 (C), Q3.3 (C), R2.2; also elsewhere on the board
HIO1: Q4.3 (D), Q5.3 (C), Q6.3 (C), R8.2; also elsewhere on the board
HIO2: Q7.3 (D), Q8.3 (C), Q9.3 (C), R14.2; also elsewhere on the board
HV: Q2.2 (E), Q5.2 (E), Q8.2 (E), R2.1, R3.1, R8.1, R9.1, R14.1, R15.1; also elsewhere on the board
HVS0: R3.2, R5.1; also elsewhere on the board
HVS1: R9.2, R11.1; also elsewhere on the board
HVS2: R15.2, R17.1; also elsewhere on the board
LIO0: Q1.2 (S), R1.2; also elsewhere on the board
LIO1: Q4.2 (S), R7.2; also elsewhere on the board
LIO2: Q7.2 (S), R13.2; also elsewhere on the board
LV: Q1.1 (G), Q4.1 (G), Q7.1 (G), R1.1, R7.1, R13.1; also elsewhere on the board
unnamed: Q2.1 (B), R5.2
unnamed: Q3.1 (B), R6.2
unnamed: Q5.1 (B), R11.2
unnamed: Q6.1 (B), R12.2
unnamed: Q8.1 (B), R17.2
unnamed: Q9.1 (B), R18.2

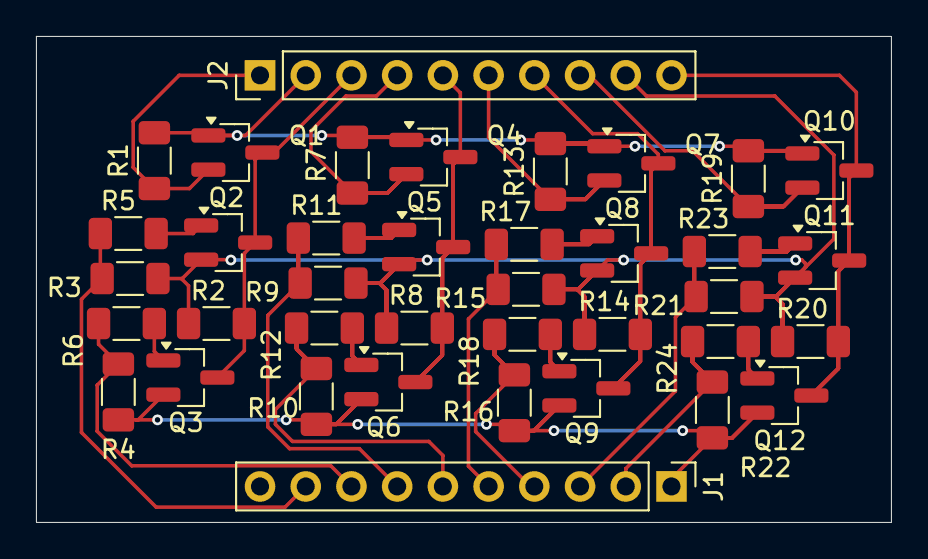
[picture p11: board pin_interface_circuit.kicad_pcb from above]

Board: 2 copper layers, 47.5 x 27.0 mm, 38 parts (0 on the bottom side), 27 nets.
