ray33ee/DCT/microDCT/Core/Src/main.c

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
/* Includes ------------------------------------------------------------------*/
#include "main.h"

ADC_HandleTypeDef hadc2;
ADC_HandleTypeDef hadc5;

I2C_HandleTypeDef hi2c1;

RNG_HandleTypeDef hrng;

TIM_HandleTypeDef htim2;
TIM_HandleTypeDef htim3;

UART_HandleTypeDef huart2;

void SystemClock_Config(void);
static void MX_GPIO_Init(void);
static void MX_TIM2_Init(void);
static void MX_USART2_UART_Init(void);
static void MX_I2C1_Init(void);
static void MX_ADC2_Init(void);
static void MX_ADC5_Init(void);
static void MX_RNG_Init(void);
static void MX_TIM3_Init(void);
/* USER CODE BEGIN 0 */


struct Executable_State exec_state;
struct VM_State vm_state;
struct PSU_STATE psu_state;
struct PP_HANDLE pp_state;

uint32_t shunt_okay_average(struct PSU_STATE* psu_state) {
	uint32_t sum = 0;

	const uint32_t size = 5;

	uint32_t set[size];

	for (int j = 0; j < size; j++) {
		set[j] = psu_shunt_diff(psu_state);
	  //printf("value: %i\n", set[j]);
	  sum += set[j];
	}

	//printf("cumulative: %i\n", sum);

	uint32_t mean = sum / size;

	sum=0;

	//printf("mean: %i\n", mean);

	for (int j = 0; j < size; j++) {
	  uint32_t diff = set[j] - mean;
	  //printf("diff: %i\n", diff);
	  sum += diff < 0 ? -diff : diff;
	}

	uint32_t dev = sum / size;

	//printf("dev: %i\n", dev);

	uint32_t lower = mean - 3 * dev - 1;
	uint32_t upper = mean + 3 * dev + 1;

	//printf("lower: %i\n", lower);

	//printf("upper: %i\n", upper);

	sum=0;

	uint32_t count = 0;
	for (int j = 0; j < size; j++) {
	  if (set[j] > lower-1 && set[j] <= upper+1) {
		  sum += set[j];
		  count++;
	  }

	}

	if (sum == 0) {
		return mean;
	} else {
		return sum / count;
	}
}

/* USER CODE END 0 */

/**
  * @brief  The application entry point.
  * @retval int
  */
int main(void)
{

  /* MCU Configuration--------------------------------------------------------*/

  /* Reset of all peripherals, Initializes the Flash interface and the Systick. */
  HAL_Init();

  /* Configure the system clock */
  SystemClock_Config();

  /* Initialize all configured peripherals */
  MX_GPIO_Init();
  MX_TIM2_Init();
  MX_USART2_UART_Init();
  MX_I2C1_Init();
  MX_ADC2_Init();
  MX_ADC5_Init();
  MX_RNG_Init();
  MX_TIM3_Init();
  /* USER CODE BEGIN 2 */

  //Timer 3 is used in misc_delay_us
  HAL_TIM_Base_Start(&htim3);

  uint8_t buff[100];

  /* Setup PP */

  pp_init(&pp_state, &hi2c1);

  /* Setup VM */

  const uint32_t call_stack_size = 100;
  const uint32_t operand_stack_size = 100;

  uint32_t call_stack[call_stack_size];
  uint32_t operand_stack[operand_stack_size];

  executable_init(&exec_state);

  vm_init(&vm_state, call_stack, operand_stack, call_stack_size, operand_stack_size, &exec_state, &pp_state);

  /* Setup RNG */

  rng_global_init(&hrng);

  /* Setup and test soft I2C */

  /*
  uint8_t buff[100];

  buff[0] = 0xf6;

  struct SOFT_I2C_HANDLE h2i2c;

  soft_i2c_init(&h2i2c, GPIOA, GPIO_PIN_10, GPIOC, GPIO_PIN_4, 10, 4);

  uint8_t who_am_i = 0x4F;

  int r = soft_i2c_transmit(&h2i2c, 0x3c, &who_am_i, 1);

  int r1 = soft_i2c_receive(&h2i2c, 0x3c, &who_am_i, 1);

  printf("Soft i2c %i\n", who_am_i);*/

  psu_init(&psu_state, &hadc2, &hadc5, &htim2, &TIM2->CCR1, TIM_CHANNEL_1);

  psu_intensity(&psu_state, 0);

  /* USER CODE END 2 */

  /* Infinite loop */
  /* USER CODE BEGIN WHILE */
  while (1)
  {
    /* USER CODE END WHILE */

    /* USER CODE BEGIN 3 */


	  read_uart_into_buffer(buff, 100, '\n');

	  if (buff[0] == '0') {

		  read_uart_into_buffer(buff, 100, '\n');

		  uint32_t timeout = atoi(buff);

		  vm_state.timeout = timeout;

		  get_length_from_uart(&exec_state);

		  get_rom_from_uart(&exec_state);

		  printf("ack\n");


	  } else if (buff[0] == '1') {

		  printf("%i\n", (int)vm_state.pc);
		  printf("%i\n", (int)vm_state.osp);
		  printf("%i\n", (int)vm_state.csp);
		  printf("%i\n", (int)vm_state.exec->rom[vm_state.pc]);
		  if (vm_state.osp != -1) {
			  printf("%i\n", (int)vm_peek_ops(&vm_state));
		  }
		  printf("%i\n", (int)vm_state.bp);


		  printf("ack\n");

	  } else if (buff[0] == '2') {
		  uint32_t r = 0;

		  vm_reset(&vm_state);

		  vm_start_timer(&vm_state);

		  while (r == 0) {
			  r = vm_execute(&vm_state);
		  }

		  printf("done\n");

		  printf("%i\n", r);

		  if (r == FAILURE) {
			  //If the result was a failure, send the top of the stack as the error code or reason
			  printf("%i\n", vm_peek_ops(&vm_state));
		  }
	  } else if (buff[0] == '3') {

		  //Read the pin configs into the state
		  read_uart_into_buffer(&(pp_state.pin_configs), 16, '\n');

		  //Apply the state
		  pp_setup(&pp_state);

		  printf("ack\n");


	  } else if (buff[0] == '4') {

		  read_uart_into_buffer(buff, 100, '\n');

		  uint32_t num = atoi(buff);

		  psu_intensity(&psu_state, num);

		  printf("%i\n", num);

		  printf("ack\n");


	  }


	  /*mcp23017_gpio(&u2, 0b01000000, 0xFFFF);


	  HAL_Delay(1000);

	  mcp23017_gpio(&u2, 0b01000000, 0);

	  HAL_Delay(1000);


	  printf("Donez\n");*/

	  //vm_execute(&vm_state);

	  //printf("Enter pwm: \n");

	  //read_uart_into_buffer(buff, 100, '\n');

	  //psu_intensity(&psu_state, atoi(buff));

	  //printf("drop: %i\n", psu_shunt_diff(&psu_state));



	  /*for (int i = 0; i < 1600; i++) {
		  psu_intensity(&psu_state, i);

		  HAL_Delay(1);

		  voltages[i] = psu_output_voltage(&psu_state);

		  values[i] = 4096 * 10 - (psu_shunt_diff(&psu_state) + psu_shunt_diff(&psu_state) + psu_shunt_diff(&psu_state) + psu_shunt_diff(&psu_state) + psu_shunt_diff(&psu_state)
		  	  	  	  + psu_shunt_diff(&psu_state) + psu_shunt_diff(&psu_state) + psu_shunt_diff(&psu_state) + psu_shunt_diff(&psu_state) + psu_shunt_diff(&psu_state));

	  }

	  psu_intensity(&psu_state, 0);

	  HAL_Delay(20);


	  for (int i = 0; i < 1600; i++) {
		  printf("%i %i %f\n", i, values[i], convert_adc_to_voltage(voltages[i]));

	  }*/


  }
  /* USER CODE END 3 */
}

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
