ray33ee/DCT/microDCT/microDCT.ioc

Mcu.UserName=STM32G474RETx
PA10.Signal=SPI2_MISO
PA11.Signal=SPI2_MOSI
PA13.GPIO_Label=T_SWDIO
PA13.Signal=SYS_JTMS-SWDIO
PA14.GPIO_Label=T_SWCLK
PA14.Signal=SYS_JTCK-SWCLK
PA15.Signal=I2C1_SCL
PA2.Signal=USART2_TX
PA3.Signal=USART2_RX
PA5.Signal=S_TIM2_CH1
PA6.Signal=ADC2_IN3
PA7.Signal=ADC2_IN4
PA8.Signal=ADC5_IN1
PB13.Signal=SPI2_SCK
PB3.GPIO_Label=T_SWO
PB3.Signal=SYS_JTDO-SWO
PB7.Signal=I2C1_SDA
PC14-OSC32_IN.GPIO_Label=RCC_OSC32_IN
PC14-OSC32_IN.Signal=RCC_OSC32_IN
PC15-OSC32_OUT.GPIO_Label=RCC_OSC32_OUT
PC15-OSC32_OUT.Signal=RCC_OSC32_OUT
PF0-OSC_IN.GPIO_Label=RCC_OSC_IN
PF0-OSC_IN.Signal=RCC_OSC_IN
PF1-OSC_OUT.GPIO_Label=RCC_OSC_OUT
PF1-OSC_OUT.Signal=RCC_OSC_OUT
